clnhlzmn/cat-tracker/main-board/cat-tracker-board.kicad_pcb

## KiCad design main-board/cat-tracker-board.kicad_pcb (2022-01-19)

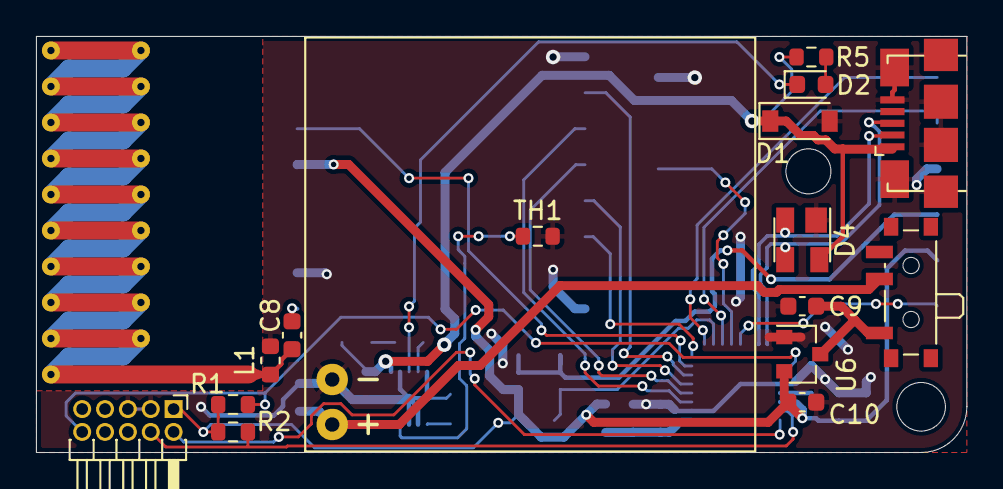
[picture p1: board cat-tracker-board.kicad_pcb from above]

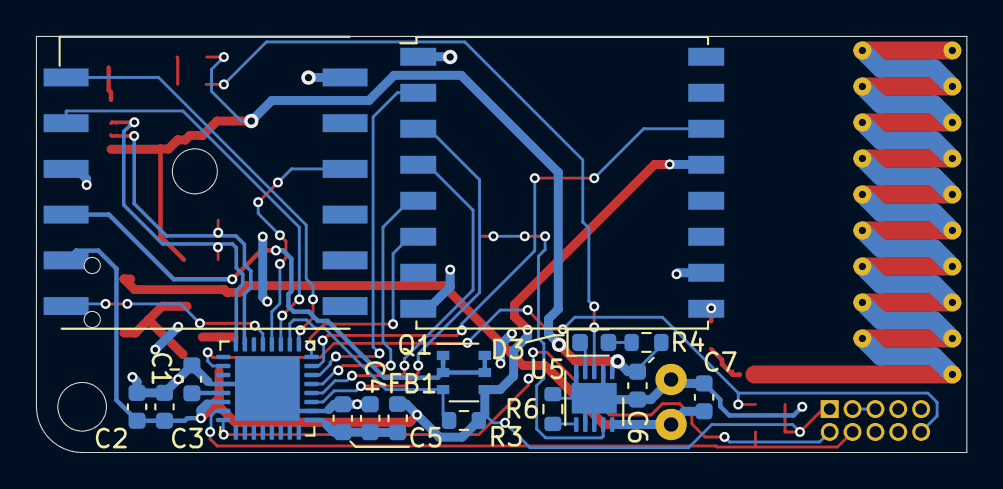
[picture p2: board cat-tracker-board.kicad_pcb from below]

Board: 2 copper layers, 51.7 x 23.1 mm, 34 parts (17 on the bottom side), 32 nets.

Parts:
AE1: Antenna; Texas_SWRA416_868MHz_915MHz
BT1: ASR00007; TinyCircuits_ASR00007
C1, C9, C10: 1 uF; C_0603_1608Metric
C2, C4: 10 uF; C_0603_1608Metric
C3, C5: 0.1 uF; C_0603_1608Metric
C6, C7: 4.7 uF; C_0603_1608Metric
C8: 1 pF; C_0603_1608Metric
D1: PTVS5V0S1UTR,115; D_SOD-123
D2, D3: LED; LED_0603_1608Metric
D4: PRTR5V0U2X; SOT-143
FB1: Ferrite_Bead; L_0603_1608Metric
J1: Conn_01x10; PinHeader_2x05_P1.27mm_Horizontal
J3: USB_B_Micro; USB_Micro-B_Amphenol_10118192_Horizontal
L1: 12 nH; L_0603_1608Metric
Q1: SI3443DDV-T1-GE3; TSOP-6_1.65x3.05mm_P0.95mm
R1, R2, R3: 100k; R_0603_1608Metric
R4, R5: 750; R_0603_1608Metric
R6: 14K; R_0603_1608Metric
SW1: PCM12SMTR; SW_SPDT_PCM12
TH1: 10K; R_0603_1608Metric
U1: ATSAMD21E18A-M; QFN-32-1EP_5x5mm_P0.5mm_EP3.6x3.6mm
U3: L80-R; Quectel_L80-R
U4: RFM95W-915S2; HOPERF_RFM9XW_SMD
U5: MCP73837/8-MF; DFN-10-1EP_3x3mm_P0.5mm_EP1.7x2.5mm
U6: MCP1700T-3602E/TT; SOT-23

Connections:
/GND: BT1.2 (-), C1.1, C2.2, C3.1, C4.2, C5.1, C6.2, C7.2, C9.2, C10.2, D1.2 (A2), D4.1 (GND), J1.3, J1.5, J3.5 (GND), J3.6 (Shield), L1.2, R6.2, TH1.2, U1.10 (GND), U1.28 (GND), U1.33 (EP), U3.3 (GND), U3.12 (GND), U4.1 (GND), U4.8 (GND), U4.10 (GND), U5.2 (VUSB), U5.5 (VSS), U5.7 (PROG2), U5.8 (~PG/~TE), U5.11 (VSS), U6.1 (GND)
/GPS_1PPS: U1.21 (PA22), U3.6 (1PPS)
/GPS_EN: Q1.3 (G), R3.2, U1.18 (PA17)
/GPS_RX: U1.19 (PA18), U3.2 (TXD1)
/GPS_TX: U1.17 (PA16), U3.1 (RXD1)
/GPS_nRESET: U1.20 (PA19), U3.10 (~RESET)
/MISO: U1.14 (PA11), U4.2 (MISO)
/MOSI: U1.11 (PA08), U4.3 (MOSI)
/NSS: U1.13 (PA10), U4.5 (NSS)
/RFM_INT: U1.15 (PA14), U4.14 (DIO0)
/RFM_RESET: U1.16 (PA15), U4.6 (RESET)
/SCK: U1.12 (PA09), U4.4 (SCK)
/SWCLK: J1.4, R2.2, U1.31 (PA30)
/SWDIO: J1.2, U1.32 (PA31)
/USBD+: D4.3 (I/O2), J3.3 (D+), U1.24 (PA25)
/USBD-: D4.2 (I/O1), J3.2 (D-), U1.23 (PA24)
/VBAT: BT1.1 (+), C7.1, SW1.2 (B), U5.10 (VBAT)
/VDD: C2.1, C3.2, C10.1, FB1.1, J1.1, Q1.4 (S), R1.1, R2.1, R3.1, U1.30 (VDDIN), U3.5 (V_BCKP), U4.13 (3.3V), U6.2 (VO)
/VUSB: C6.1, D1.1 (A1), D4.4 (VCC), J3.1 (VBUS), R4.2, R5.2, U5.1 (VAC)
/nRESET: J1.10, R1.2, U1.26 (~RESET)
unnamed: AE1.1 (A), C8.2, L1.1
unnamed: C1.2, U1.29 (VDDCORE)
unnamed: C4.1, C5.2, FB1.2, U1.9 (VDDANA)
unnamed: C9.1, SW1.1 (A), U6.3 (VI)
unnamed: D2.1 (K), U5.3 (STAT1)
unnamed: D2.2 (A), R5.1
unnamed: D3.1 (K), U5.4 (STAT2)
unnamed: D3.2 (A), R4.1
unnamed: Q1.1 (D), Q1.2 (D), Q1.5 (D), Q1.6 (D), U3.4 (VCC)
unnamed: R6.1, U5.6 (PROG1)
unnamed: TH1.1, U5.9 (THERM)
unnamed: C8.1, U4.9 (ANT)
