clnhlzmn/cat-tracker/(commit log)

2021-04-23 Added new kicad project.
    [cat-tracker-board.kicad_pcb, cat-tracker-board.sch]
2021-04-29 Added RFM95 module.
    [cat-tracker-board.sch]
2021-04-29 Added MCU and friends and connected to radio.
    [cat-tracker-board.sch]
2021-05-01 Changed mcu to 32 pin, added usb, power.
    [cat-tracker-board.sch]
2021-05-01 Added some part numbers, updated boost regulator to a part that's not obsolete.
    [cat-tracker-board.sch]
2021-05-01 Added low voltage cutoff circuit for batteries.
    [cat-tracker-board.sch]
2021-05-02 Added GPS connector and switch, annotated symbols, and assigned footprints.
    [cat-tracker-board.sch]
2021-05-02 Fixed BJT pin numbers.
    [cat-tracker-board.sch]
2021-05-02 Updated PCB with footprints.
    [cat-tracker-board.kicad_pcb]
2021-05-02 Added cat-tracker-board.pretty for board specific footprints.
2021-05-02 Updated pcb with new BJT nets.
    [cat-tracker-board.kicad_pcb]
2021-05-02 Moved main board to sub folder.
    [cat-tracker-board.kicad_pcb, cat-tracker-board.sch]
2021-05-02 Added battery board schematic and layout.
    [battery-board.kicad_pcb, battery-board.sch]
2021-05-02 Updated battery-board gitignore.
    [battery-board.kicad_pcb]
2021-05-02 Added battery-board footprint in main-board lib.
2021-05-02 Updated main board layout with battery board footprint.
    [cat-tracker-board.kicad_pcb, cat-tracker-board.sch]
2021-05-02 Added right angle SMA connector.
2021-05-02 Added lora antenna connector.
    [cat-tracker-board.sch]
2021-05-02 Added aux bom with antenna PN.
    [cat-tracker-board-bom-aux.csv]
2021-05-02 Assigned remaining main-board part numbers.
    [cat-tracker-board.sch]
2021-05-02 Updated main board pcb.
    [cat-tracker-board.kicad_pcb]
2021-05-02 Changed programming header to right angle and updated pcb.
    [cat-tracker-board.kicad_pcb, cat-tracker-board.sch]
2021-05-02 Placed all parts on board.
    [cat-tracker-board.kicad_pcb, cat-tracker-board.sch]
2021-05-02 Added zip tie slots.
    [cat-tracker-board.kicad_pcb]
2021-05-02 Started routing.
    [cat-tracker-board.kicad_pcb]
2021-05-02 Finished layout.
    [cat-tracker-board.kicad_pcb]
2021-05-02 Rescued ferrite bead (again?).
    [cat-tracker-board.sch]
2021-05-02 Updated battery board pns and added aux bom.
    [battery-board-bom-aux.csv, battery-board.sch]
2021-05-02 Added fasteners to main board aux bom.
    [cat-tracker-board-bom-aux.csv]
2021-05-02 Added CPH logo.
    [cat-tracker-board.kicad_pcb]
2021-05-02 Updated plot settings.
    [cat-tracker-board.kicad_pcb]
2021-05-02 Updated battery board plot settings.
    [battery-board.kicad_pcb]
2021-05-03 Added version number to boards.
    [battery-board.kicad_pcb, cat-tracker-board.kicad_pcb]
2021-05-29 Remove LVP circuit and usb/bat selector switch, add slide switch for bat, change switch ind to 10uH.
    [cat-tracker-board.kicad_pcb, cat-tracker-board.sch]
2021-05-30 Improve boost converter layout, change version to 0.1.0.
    [cat-tracker-board.kicad_pcb]
2021-05-30 Change boost converter inductor to the one used in the reference design.
    [cat-tracker-board.kicad_pcb, cat-tracker-board.sch]
2021-05-31 Remove boost converter, replace with low Vf schottky.
    [cat-tracker-board.kicad_pcb, cat-tracker-board.sch]
2021-07-03 Remove battery board.
    [battery-board-bom-aux.csv, battery-board.kicad_pcb, battery-board.sch]
2021-07-04 Add A5135-H.
    [cat-tracker-board.sch]
2021-07-05 Add L80 GPS, charge ic, and battery protection ic.
    [cat-tracker-board.kicad_pcb, cat-tracker-board.sch]
2021-07-05 Add charger support components.
    [cat-tracker-board.sch]
2021-07-05 Add support components for battery protection.
    [cat-tracker-board.sch]
2021-07-06 Rescue symbols.
    [cat-tracker-board.sch]
2021-07-06 Add MCP 1700 3.6V regulator.
    [cat-tracker-board.sch]
2021-07-06 Annotate, assign footprints, and assign part numbers.
    [cat-tracker-board.kicad_pcb, cat-tracker-board.sch]
2021-07-07 Change usb to micro B type.
    [cat-tracker-board.kicad_pcb, cat-tracker-board.sch]
2021-07-07 Change passives to 0603, change mcu to qfp, change battery to asr00007.
    [cat-tracker-board.kicad_pcb, cat-tracker-board.sch]
2021-07-08 Add antenna, change USB to smd, add gps switch, connect gps.
    [cat-tracker-board.kicad_pcb, cat-tracker-board.sch]
2021-07-08 Rescue MCU symbol.
    [cat-tracker-board.sch]
2021-07-08 Arrange all parts within board edge.
    [cat-tracker-board.kicad_pcb]
2021-07-09 Rearrange parts.
    [cat-tracker-board.kicad_pcb, cat-tracker-board.sch]
2021-07-09 Change differential pair settings back to default.
    [cat-tracker-board.kicad_pcb]
2021-07-09 Add some tracks.
    [cat-tracker-board.kicad_pcb, cat-tracker-board.sch]
2021-07-10 Change switch connection to improve layout.
    [cat-tracker-board.kicad_pcb, cat-tracker-board.sch]
2021-07-15 Work on layout.
    [cat-tracker-board.kicad_pcb]
2021-07-16 Correct footprint assignment for U5 and work on layout.
    [cat-tracker-board.kicad_pcb, cat-tracker-board.sch]
2021-07-18 Route almost everything.
    [cat-tracker-board.kicad_pcb, cat-tracker-board.sch]
2022-01-17 Update to KiCad v6
    [cat-tracker-board-bom.csv, cat-tracker-board.kicad_pcb, cat-tracker-board.kicad_sch]
2022-01-17 Add antenna matching, update some PNs
    [cat-tracker-board-bom.csv, cat-tracker-board.kicad_pcb, cat-tracker-board.kicad_sch]
2022-01-17 Clean up silk
    [cat-tracker-board.kicad_pcb]
2022-01-17 Remove unused items from aux bom
    [cat-tracker-board-bom-aux.csv, cat-tracker-board-bom.csv]
2022-01-18 Add alternate for GPS
    [cat-tracker-board-bom.csv, cat-tracker-board.kicad_sch]
2022-01-18 Start changing to MCP73838
    [cat-tracker-board.kicad_pcb, cat-tracker-board.kicad_sch]
2022-01-19 Finish layout for new charger
    [cat-tracker-board.kicad_pcb]
2022-01-20 Fixed charger symbol
    [cat-tracker-board.kicad_sch]
2022-01-20 Update bom
    [cat-tracker-board-bom.csv, cat-tracker-board.kicad_sch]
